Dharshna848/wristrack/README.md

**WrisTrack**

**1. Project Overview**  
   
 WrisTrack is an engineering project designed to measure wrist-angle variation during cricket bowling using wearable sensors, Arduino and Python.  

**2. Project Documentation**

  The following documents contain the complete project details, including the problem statement, design, development, setup, testing, results, challenges and limitation.  

  Folder     : Docs/        

  **Files**  
  
   i) WrisTrack.pdf   - For Viewing  
  
  ii) WrisTrack.docx  - Editable Version  

**3.Source Code**  

  The source code contains the Arduino and Python programs used for sensor data acquisition, communication, and data logging.

  **a) Arduino**  
  
   Folder     : Source_code/Arduino/      
     
  **Files** 
  
  i) Wristrack_code.ino   - Arduino code  
  
  **b) Python**  
  
   Folder     : Source_code/Python/    
   
  **Files**  
  
   i) udplogger.py         - Python program to receive the status of ball deliveries and store it in a csv file  
   
  ii) Plot_graph.py        - Python program to plot the ball deliveries  

**4. Results** 

  This section contains the recorded outputs generated during project testing, including Arduino sensor output, Python logger results, and graphical visualization of the collected data. Detailed test cases and analysis are available in the project documentation.

  Folder     : Results/    

  **Files**  
   
   i) arduino_output_final.txt             - Results from Arduino while connected through USB  
    
  ii) wrist_deviation_detector_python.txt  - Results from Python Udp logger  
   
 iii) wrist_deviation_chart.png            - Results from Graph plotter  

**5. Demonstration**  

  This section contains a video demonstration of the WrisTrack prototype, showing the system in operation and the recording of measurement results.

  Folder     : Demo/    

  **Files**  
  
  i) Demo_Recording.mp4 - Recording for WrisTrack project demo. Download to view
